MattisLind/DISKEmu-v5-1/bom/bom.csv

Designator | Quantity | Value | Footprint | Manufacturer | MPN | LCSC Part # | JLCPCB Class | Assembly | Available Order Qty | Stock Qty | Unit Price USD | Checked | Source | Notes
C1, C2, C3, C4, C5, C6, C7, C8, C9, C10, C11, C12, C13, C14, C15, C16, C31, C32, C33, C34, C35, C36, C37, C38, C39, C40, C41, C42, C43, C48, C49, C50, C51, C52, C53, C54, C55, C56, C57, C58, C59 | 41 | 100n | Capacitor_SMD:C_0603_1608Metric_Pad1.08x0.95mm_HandSolder | YAGEO | CC0603KRX7R9BB104 | C14663 | Basic | JLCPCB SMT | 16490356 | 34231944 | 0.0155 | 2026-11-07 | https://jlcpcb.com/partdetail/C14663
C17, C20 | 2 | 22u | Capacitor_Tantalum_SMD:CP_EIA-3528-21_Kemet-B_HandSolder | KYOCERA AVX | TAJB226K016RNJ | C8020 | Extended | JLCPCB SMT | 42042 | 44354 | 0.2913 | 2026-11-07 | https://jlcpcb.com/partdetail/C8020
C18, C19, C21, C22, C23, C24, C25, C26, C27, C28, C29, C30, C44, C45, C60, C61 | 16 | 4u7 | Capacitor_SMD:C_1206_3216Metric_Pad1.33x1.80mm_HandSolder | FH (Guangdong Fenghua Advanced Tech) | 1206B475K500NT | C29823 | Basic | JLCPCB SMT | 511902 | 660242 | 0.0697 | 2026-11-07 | https://jlcpcb.com/partdetail/C29823
C46, C47 | 2 | 30p C0G | Capacitor_SMD:C_0603_1608Metric_Pad1.08x0.95mm_HandSolder | FH (Guangdong Fenghua Advanced Tech) | 0603CG300J500NT | C1658 | Basic | JLCPCB SMT | 323324 | 403970 | 0.0051 | 2026-11-07 | https://jlcpcb.com/partdetail/C1658
D1 | 1 | LED Green | LED_SMD:LED_0805_2012Metric_Pad1.15x1.40mm_HandSolder | Hubei KENTO Elec | KT-0805G | C2297 | Basic | JLCPCB SMT | 1720084 | 1959976 | 0.0164 | 2026-11-07 | https://jlcpcb.com/partdetail/C2297
FB1, FB2 | 2 | 600R @100MHz | Inductor_SMD:L_0805_2012Metric_Pad1.05x1.20mm_HandSolder | Sunlord | GZ2012D601TF | C1017 | Basic | JLCPCB SMT | 381906 | 444082 | 0.02 | 2026-11-07 | https://jlcpcb.com/partdetail/C1017
J2 | 1 | TYPE-C-31-M-12 | Connector_USB:USB_C_Receptacle_HRO_TYPE-C-31-M-12 | Korean Hroparts Elec | TYPE-C-31-M-12 | C165948 | Extended | JLCPCB SMT | 307783 | 320595 | 0.1868 | 2026-11-07 | https://jlcpcb.com/partdetail/C165948
J3 | 1 | CPLD JTAG | Connector_IDC:IDC-Header_2x05_P2.54mm_Horizontal | BOOMELE(Boom Precision Elec) | 2.54-2*5PBent Header | C9140 | Extended | Hand-fit | 40414 | 41601 | 0.1237 | 2026-11-07 | https://jlcpcb.com/partdetail/C9140 | Through-hole connector/header; hand-fit or quote separate THT assembly. Check body clearance in PCB update.
J4 | 1 | AVR UPDI | Connector_IDC:IDC-Header_2x03_P2.54mm_Horizontal | BOOMELE(Boom Precision Elec) | 2.54-2*3PBent Header | C34945 | Extended | Hand-fit | 1621 | 1917 | 0.126 | 2026-11-07 | https://jlcpcb.com/partdetail/C34945 | Through-hole connector/header; hand-fit or quote separate THT assembly. Check body clearance in PCB update.
J5 | 1 | SD-CARD 11P | HP21xx_Connectors:SD_SHOUHAN_SD-CARD-11P | SHOU HAN | SD-CARD 11P | C7529393 | Extended | JLCPCB SMT | 9817 | 9934 | 0.0647 | 2026-11-07 | https://jlcpcb.com/partdetail/C7529393
J6 | 1 | DEBUG1 | Connector_PinSocket_2.54mm:PinSocket_1x04_P2.54mm_Horizontal | BOOMELE(Boom Precision Elec) | 2.54-1*4PBent round female | C88278 | Extended | Hand-fit | 328 | 329 | 0.2269 | 2026-11-07 | https://jlcpcb.com/partdetail/C88278 | Through-hole connector/header; hand-fit or quote separate THT assembly. Check body clearance in PCB update.
J7 | 1 | POWER | Connector_PinHeader_2.54mm:PinHeader_1x02_P2.54mm_Horizontal | XKB Connection | X6511WR-02H-C60D30R1 | C2883840 | Extended | Hand-fit | 2515 | 2519 | 0.0776 | 2026-11-07 | https://jlcpcb.com/partdetail/C2883840 | Through-hole connector/header; hand-fit or quote separate THT assembly. Check body clearance in PCB update.
JP1 | 1 | CONSOLE / UPDI | Connector_PinHeader_2.54mm:PinHeader_2x03_P2.54mm_Vertical | BOOMELE(Boom Precision Elec) | 2.54-2*3PPin | C65114 | Extended | Hand-fit | 60626 | 63214 | 0.0454 | 2026-11-07 | https://jlcpcb.com/partdetail/C65114 | Through-hole connector/header; hand-fit or quote separate THT assembly. Check body clearance in PCB update.
JP1 shunts (2), JP2 shunts (3) | 5 | 2.54mm removable shunt | Accessory | BOOMELE(Boom Precision Elec) | 2.54Short Circuit Cap Opening | C5305 | Extended | Accessory | 886904 | 888990 | 0.0098 | 2026-11-07 | https://jlcpcb.com/partdetail/C5305 | Fit two column-wise shunts on JP1 and three row-wise shunts on JP2.
JP2 | 1 | ONBOARD JTAG ENABLE | Connector_PinHeader_2.54mm:PinHeader_2x03_P2.54mm_Vertical | BOOMELE(Boom Precision Elec) | 2.54-2*3PPin | C65114 | Extended | Hand-fit | 60626 | 63214 | 0.0454 | 2026-11-07 | https://jlcpcb.com/partdetail/C65114 | Through-hole connector/header; hand-fit or quote separate THT assembly. Check body clearance in PCB update.
R1, R2 | 2 | 680 | Resistor_SMD:R_0603_1608Metric_Pad0.98x0.95mm_HandSolder | UNI-ROYAL(Uniroyal Elec) | 0603WAF6800T5E | C23228 | Basic | JLCPCB SMT | 1474165 | 1677487 | 0.0021 | 2026-11-07 | https://jlcpcb.com/partdetail/C23228
R3, R4, R5, R16 | 4 | 330 | Resistor_SMD:R_0603_1608Metric_Pad0.98x0.95mm_HandSolder | UNI-ROYAL(Uniroyal Elec) | 0603WAF3300T5E | C23138 | Basic | JLCPCB SMT | 2165760 | 2774987 | 0.002 | 2026-11-07 | https://jlcpcb.com/partdetail/C23138
R6, R7 | 2 | 5k1 | Resistor_SMD:R_0603_1608Metric_Pad0.98x0.95mm_HandSolder | UNI-ROYAL(Uniroyal Elec) | 0603WAF5101T5E | C23186 | Basic | JLCPCB SMT | 18976060 | 20342266 | 0.0015 | 2026-11-07 | https://jlcpcb.com/partdetail/C23186
R8, R9, R10, R11, R12, R13, R14, R15, R18, R20, R21 | 11 | 12k | Resistor_SMD:R_0603_1608Metric_Pad0.98x0.95mm_HandSolder | UNI-ROYAL(Uniroyal Elec) | 0603WAF1202T5E | C22790 | Basic | JLCPCB SMT | 967561 | 1164764 | 0.0031 | 2026-11-07 | https://jlcpcb.com/partdetail/C22790
R17, R19 | 2 | 2k2 | Resistor_SMD:R_0603_1608Metric_Pad0.98x0.95mm_HandSolder | UNI-ROYAL(Uniroyal Elec) | 0603WAF2201T5E | C4190 | Basic | JLCPCB SMT | 4386233 | 5100099 | 0.0018 | 2026-11-07 | https://jlcpcb.com/partdetail/C4190
U1, U2, U3, U4, U5 | 5 | 74HC4049 | Package_SO:SOIC-16_3.9x9.9mm_P1.27mm | Texas Instruments | CD74HC4049M96 | C2871324 | Extended | JLCPCB SMT | 995 | 1007 | 0.3599 | 2026-11-07 | https://jlcpcb.com/partdetail/C2871324
U6, U7, U8, U9, U10, U11, U12, U13, U20 | 9 | 74F38 | Package_SO:SOIC-14_3.9x8.7mm_P1.27mm | Texas Instruments | SN74F38DR | C2878705 | Extended | JLCPCB SMT | 308 | 311 | 0.4727 | 2026-11-07 | https://jlcpcb.com/partdetail/C2878705
U14 | 1 | LM1117MP-3.3 | Package_TO_SOT_SMD:SOT-223-3_TabPin2 | Texas Instruments | LM1117MPX-3.3/NOPB | C9662 | Extended | JLCPCB SMT | 35333 | 35787 | 0.2555 | 2026-11-07 | https://jlcpcb.com/partdetail/C9662
U15 | 1 | ATF1508AS-10AU100 | Package_QFP:TQFP-100_14x14mm_P0.5mm | Microchip Tech | ATF1508AS-10AU100 | C31179 | Extended | JLCPCB SMT | 7 | 7 | 22.8409 | 2026-11-07 | https://jlcpcb.com/partdetail/C31179 | Only 7 available at check; reserve/sourcing check needed for a production order.
U16 | 1 | ATF1504AS-10AU44 | Package_QFP:TQFP-44_10x10mm_P0.8mm | Microchip Tech | ATF1504AS-10AU44 | C219301 | Extended | JLCPCB SMT | 1 | 3 | 8.5551 | 2026-11-07 | https://jlcpcb.com/partdetail/C219301 | Only 1 available at check; ATF1504AS standard-power variant selected, not ASL.
U17 | 1 | AVR128DB48-I/PT | Package_QFP:TQFP-48_7x7mm_P0.5mm | Microchip Tech | AVR128DB48-I/PT | C1019766 | Extended | JLCPCB SMT | 14 | 20 | 4.9833 | 2026-11-07 | https://jlcpcb.com/partdetail/C1019766 | Only 14 available at check.
U18 | 1 | FT2232HL | Package_QFP:LQFP-64_10x10mm_P0.5mm | FTDI | FT2232HL-REEL | C27882 | Extended | JLCPCB SMT | 4603 | 4816 | 10.5864 | 2026-11-07 | https://jlcpcb.com/partdetail/C27882
U19, U22 | 2 | 74LVC1G07 | Package_TO_SOT_SMD:SOT-23-5 | Texas Instruments | SN74LVC1G07DBVR | C7829 | Extended | JLCPCB SMT | 44720 | 45029 | 0.0931 | 2026-11-07 | https://jlcpcb.com/partdetail/C7829
U21 | 1 | 93LC46B-I/SN (x16) | Package_SO:SOIC-8_3.9x4.9mm_P1.27mm | Microchip Tech | 93LC46BT-I/SN | C16253 | Extended | JLCPCB SMT | 5077 | 5128 | 0.3473 | 2026-11-07 | https://jlcpcb.com/partdetail/C16253
Y1 | 1 | 12MHz 20pF | Crystal:Crystal_SMD_3225-4Pin_3.2x2.5mm | YXC Crystal Oscillators | X322512MSB4SI | C9002 | Basic | JLCPCB SMT | 208227 | 247078 | 0.0954 | 2026-11-07 | https://jlcpcb.com/partdetail/C9002
