MattisLind/DISKEmu-v5-1/bom/pcb-features.csv

Designator | Value | Footprint | Notes
J1 | QBUSDUAL | cbscpe:Q-Bus_Dual_Edge | Part of PCB fabrication; no purchased component or LCSC number
H1 | MountingHole_Pad | MountingHole:MountingHole_3.2mm_M3_DIN965_Pad | Part of PCB fabrication; no purchased component or LCSC number
H2 | MountingHole_Pad | MountingHole:MountingHole_3.2mm_M3_DIN965_Pad | Part of PCB fabrication; no purchased component or LCSC number
