MattisLind/DISKEmu-v5-1/docs/schematic-usb-programming.pdf

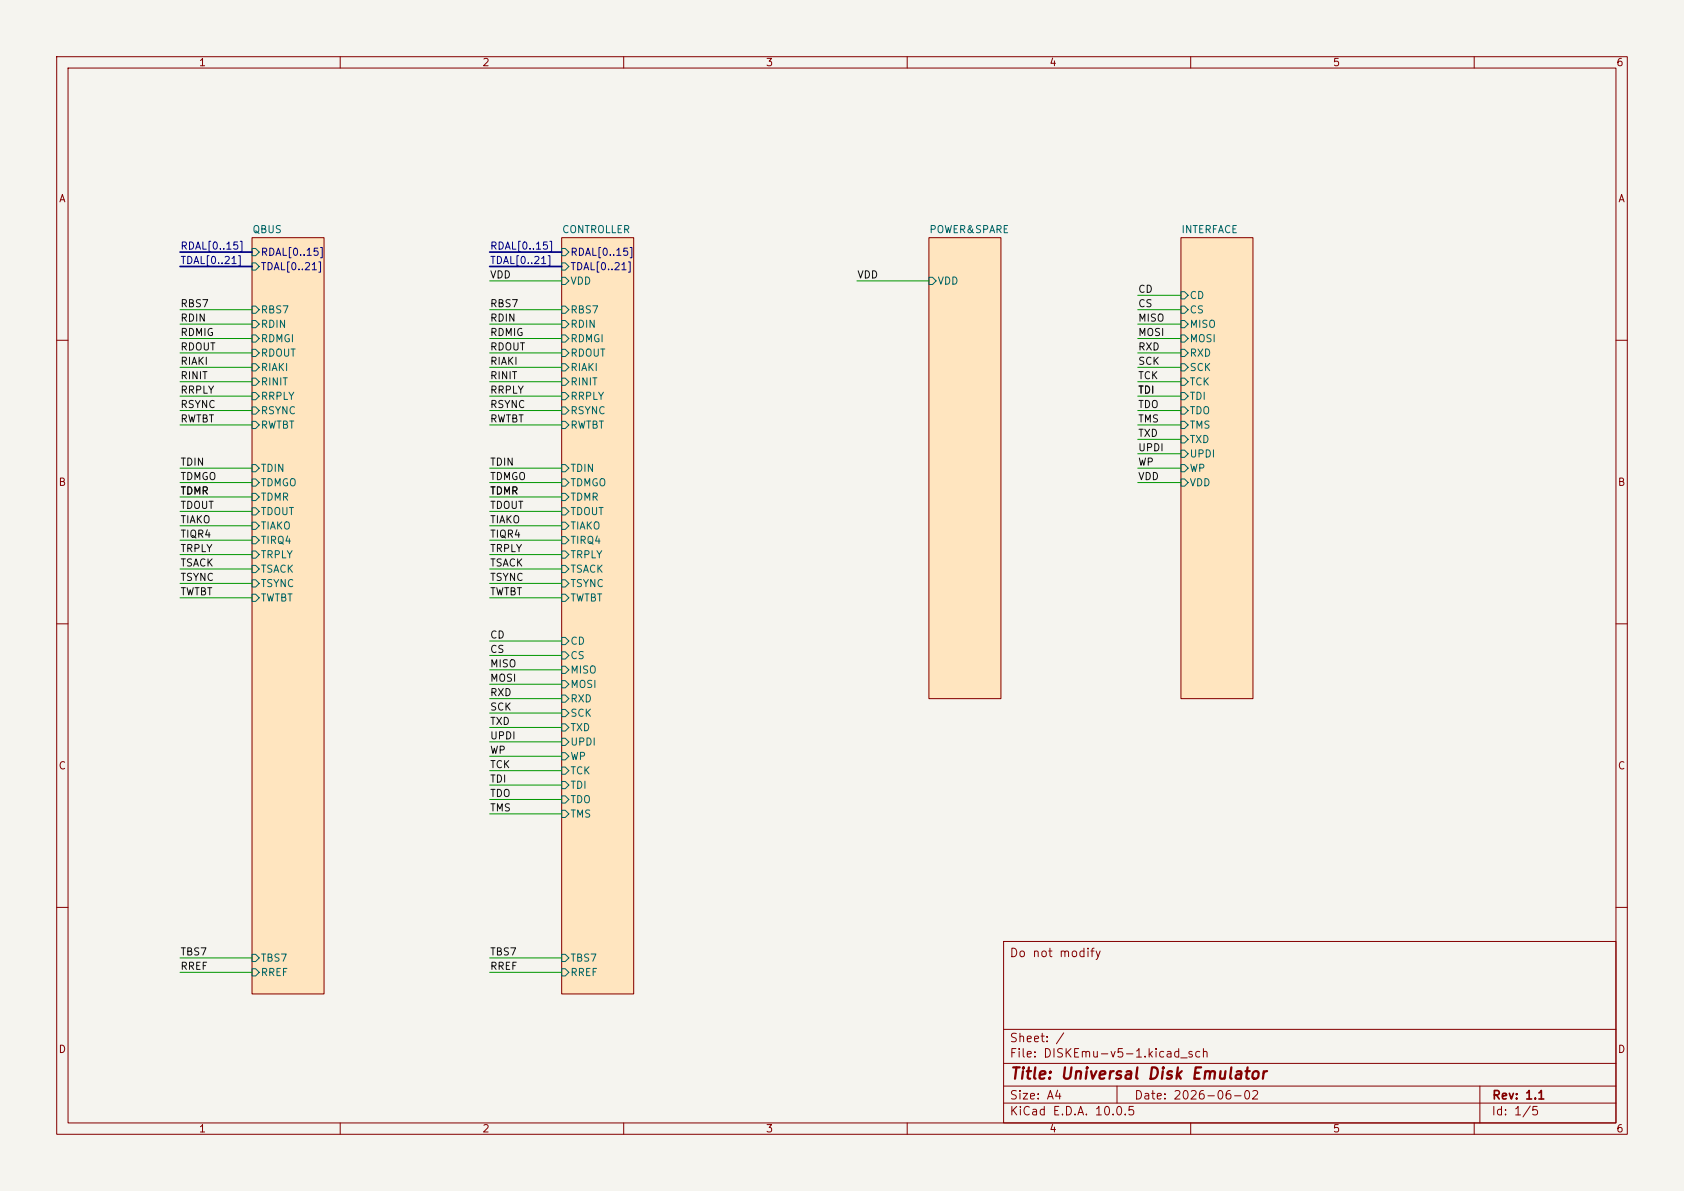
[picture p1: page 1]

INTERFACE RDOUT CD
RDAL[0..15]
TDAL[0..21] VDD
TWTBT CSRBS7 RDMIG
RDIN
RDMGI RDOUT RIAKI RINIT RRPLY RWTBT
TRPLY RINIT

RBS7
RIAKI RDMIG

Sheet: /
File: DISKEmu-v5-1.kicad_sch
Title: Universal Disk Emulator

Size: A4 | Rev: 1.1
KiCad E.D.A. 10.0.5 | Id: 1/5

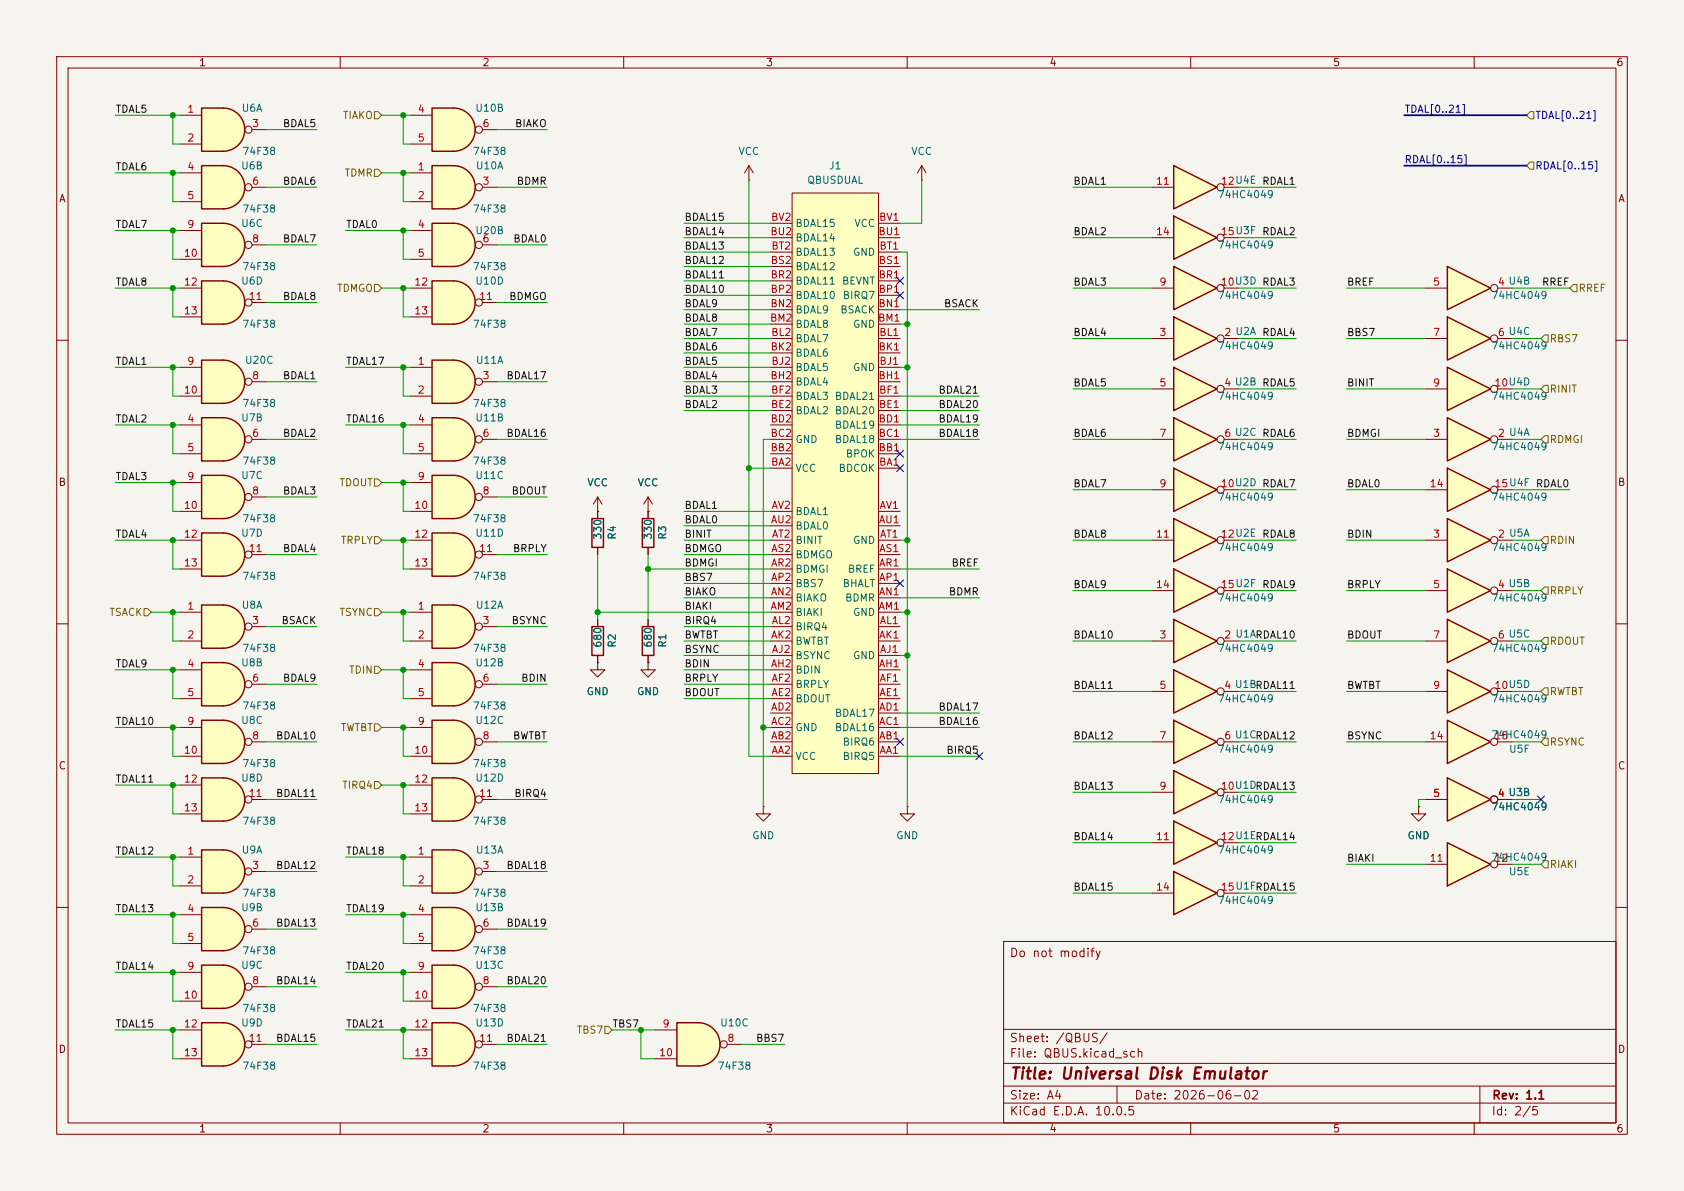
[picture p2: page 2]

RREF RBS7 RINIT RDMGI TIAKO

Do not modify GND

Sheet: /QBUS/
File: QBUS.kicad_sch
Title: Universal Disk Emulator

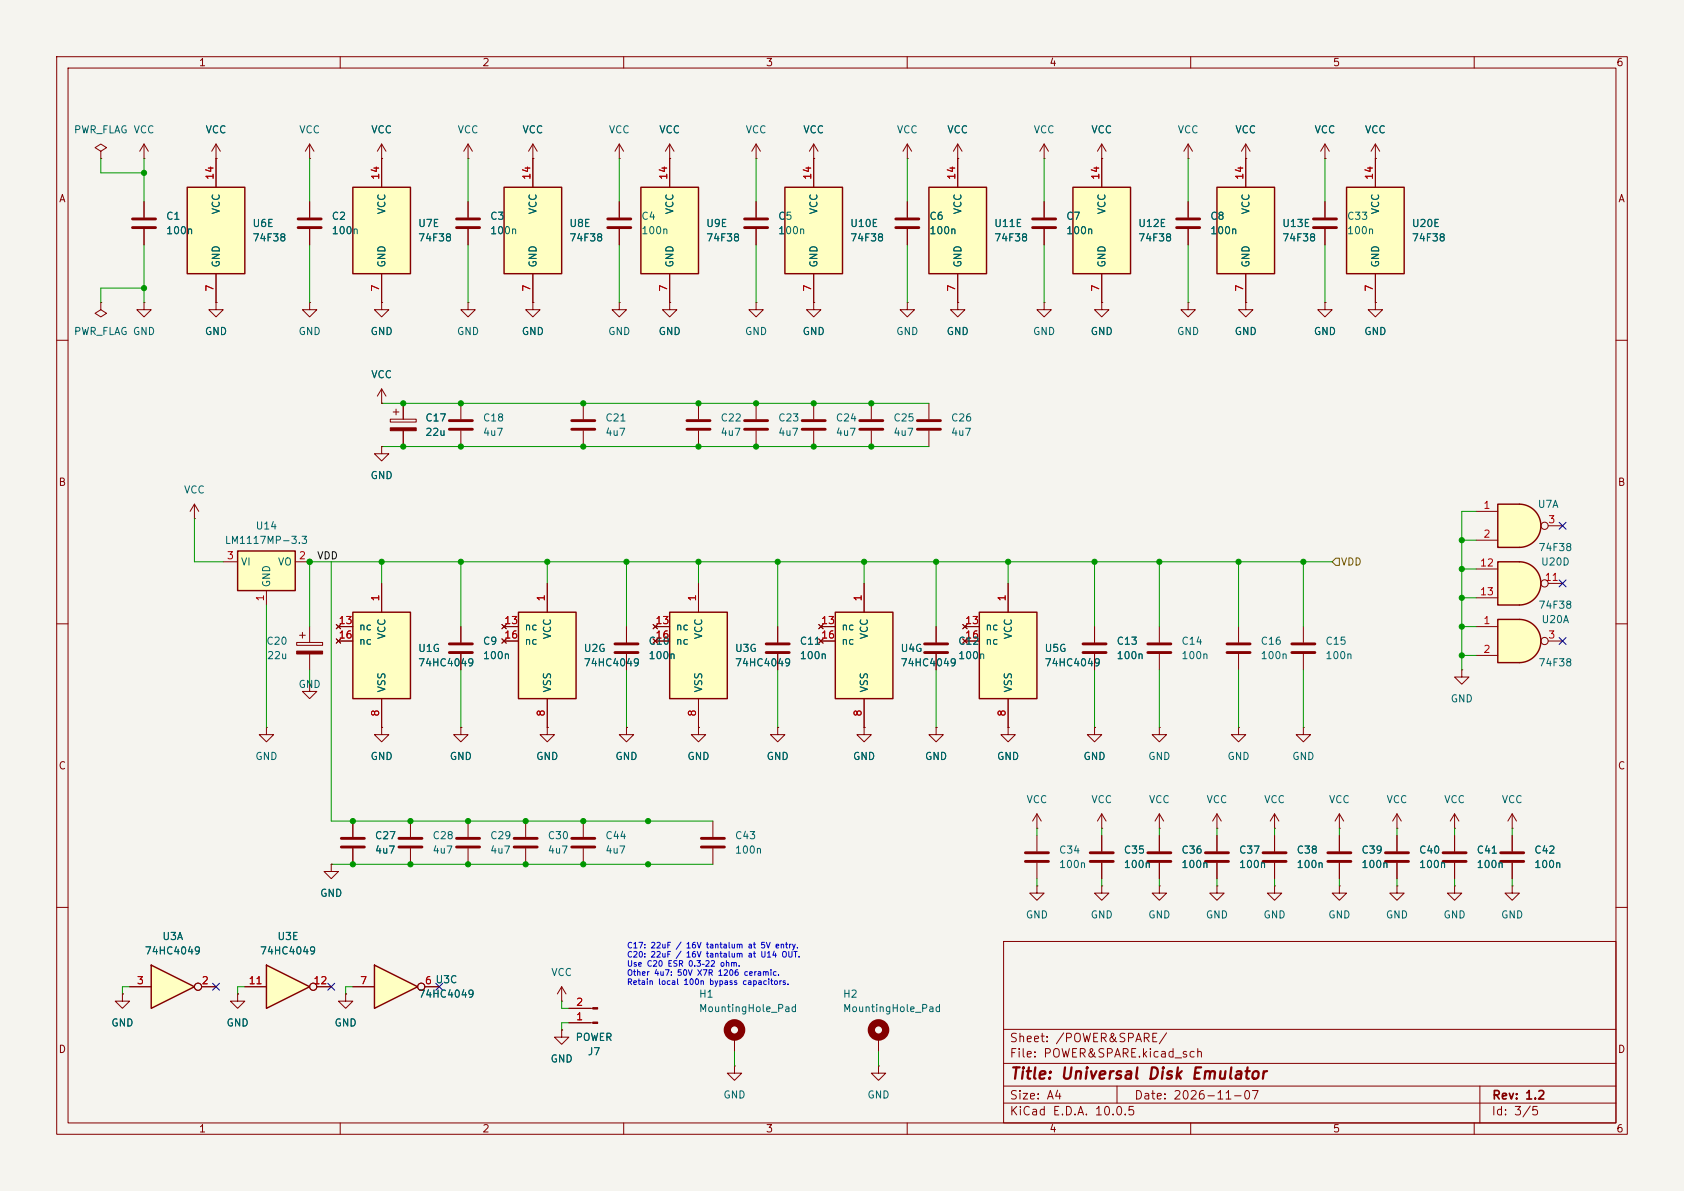
[picture p3: page 3]

Sheet: /POWER&SPARE/
File: POWER&SPARE.kicad_sch
Title: Universal Disk Emulator

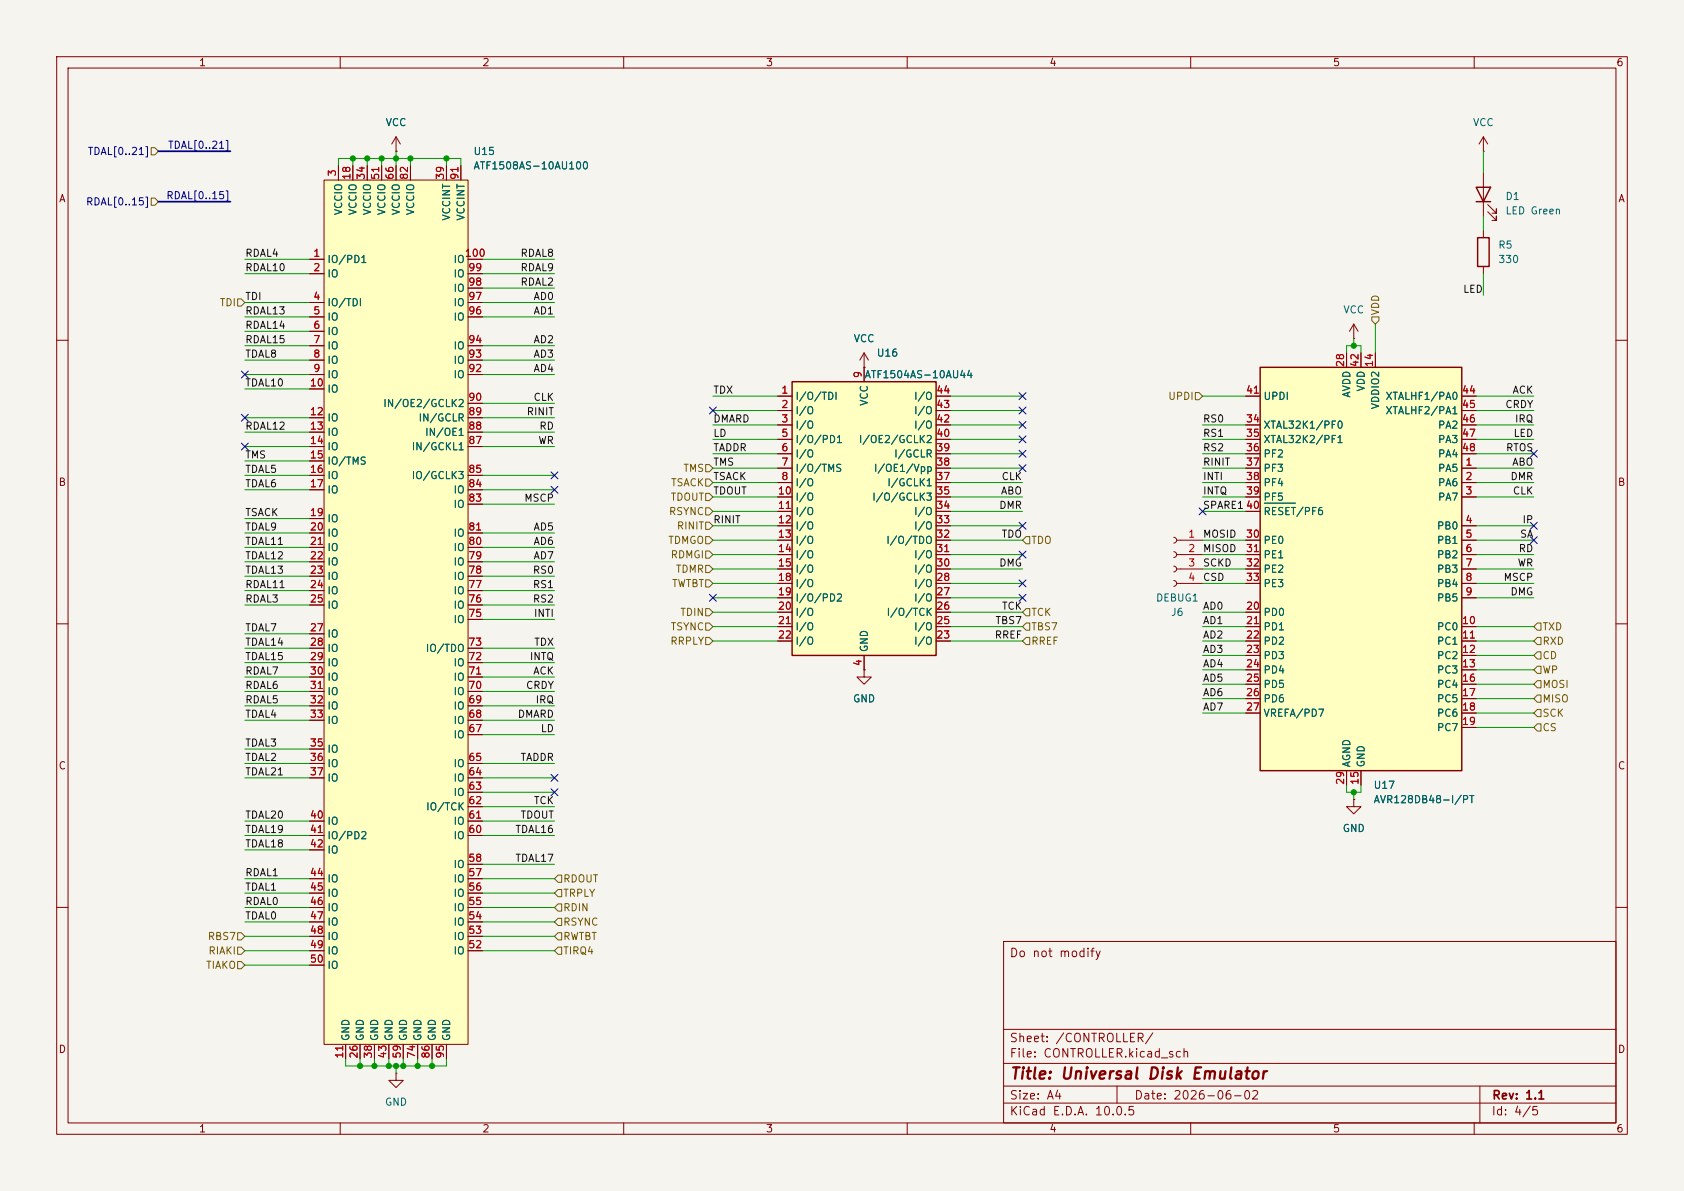
[picture p4: page 4]

ATF1508AS-10AU100

IN/GCKL1 87 IN/OE1 88 IN/GCLR 89 IN/OE2/GCLK2 90 VCCINT 91

IO 60 IO 61 IO/TCK 62 IO 63 IO 64 IO 65 VCCIO 66

IO 75 IO 76 IO 77 IO 78 IO 79 IO 80 IO 81 VCCIO 82

IO 92 IO 93 IO 94 GND 95

AD2 RDAL2 RDAL9 RDAL8

TDAL10
IO 83 IO 84 IO/GCLK3 85 GND 86

RINIT CLK

IO 67 IO 68 IO 69 IO 70 IO 71 IO 72 IO/TDO 73 GND 74

IO 52 IO 53 IO 54 IO 55 IO 56 IO 57 IO 58 GND 59

Sheet: /CONTROLLER/
File: CONTROLLER.kicad_sch
Title: Universal Disk Emulator

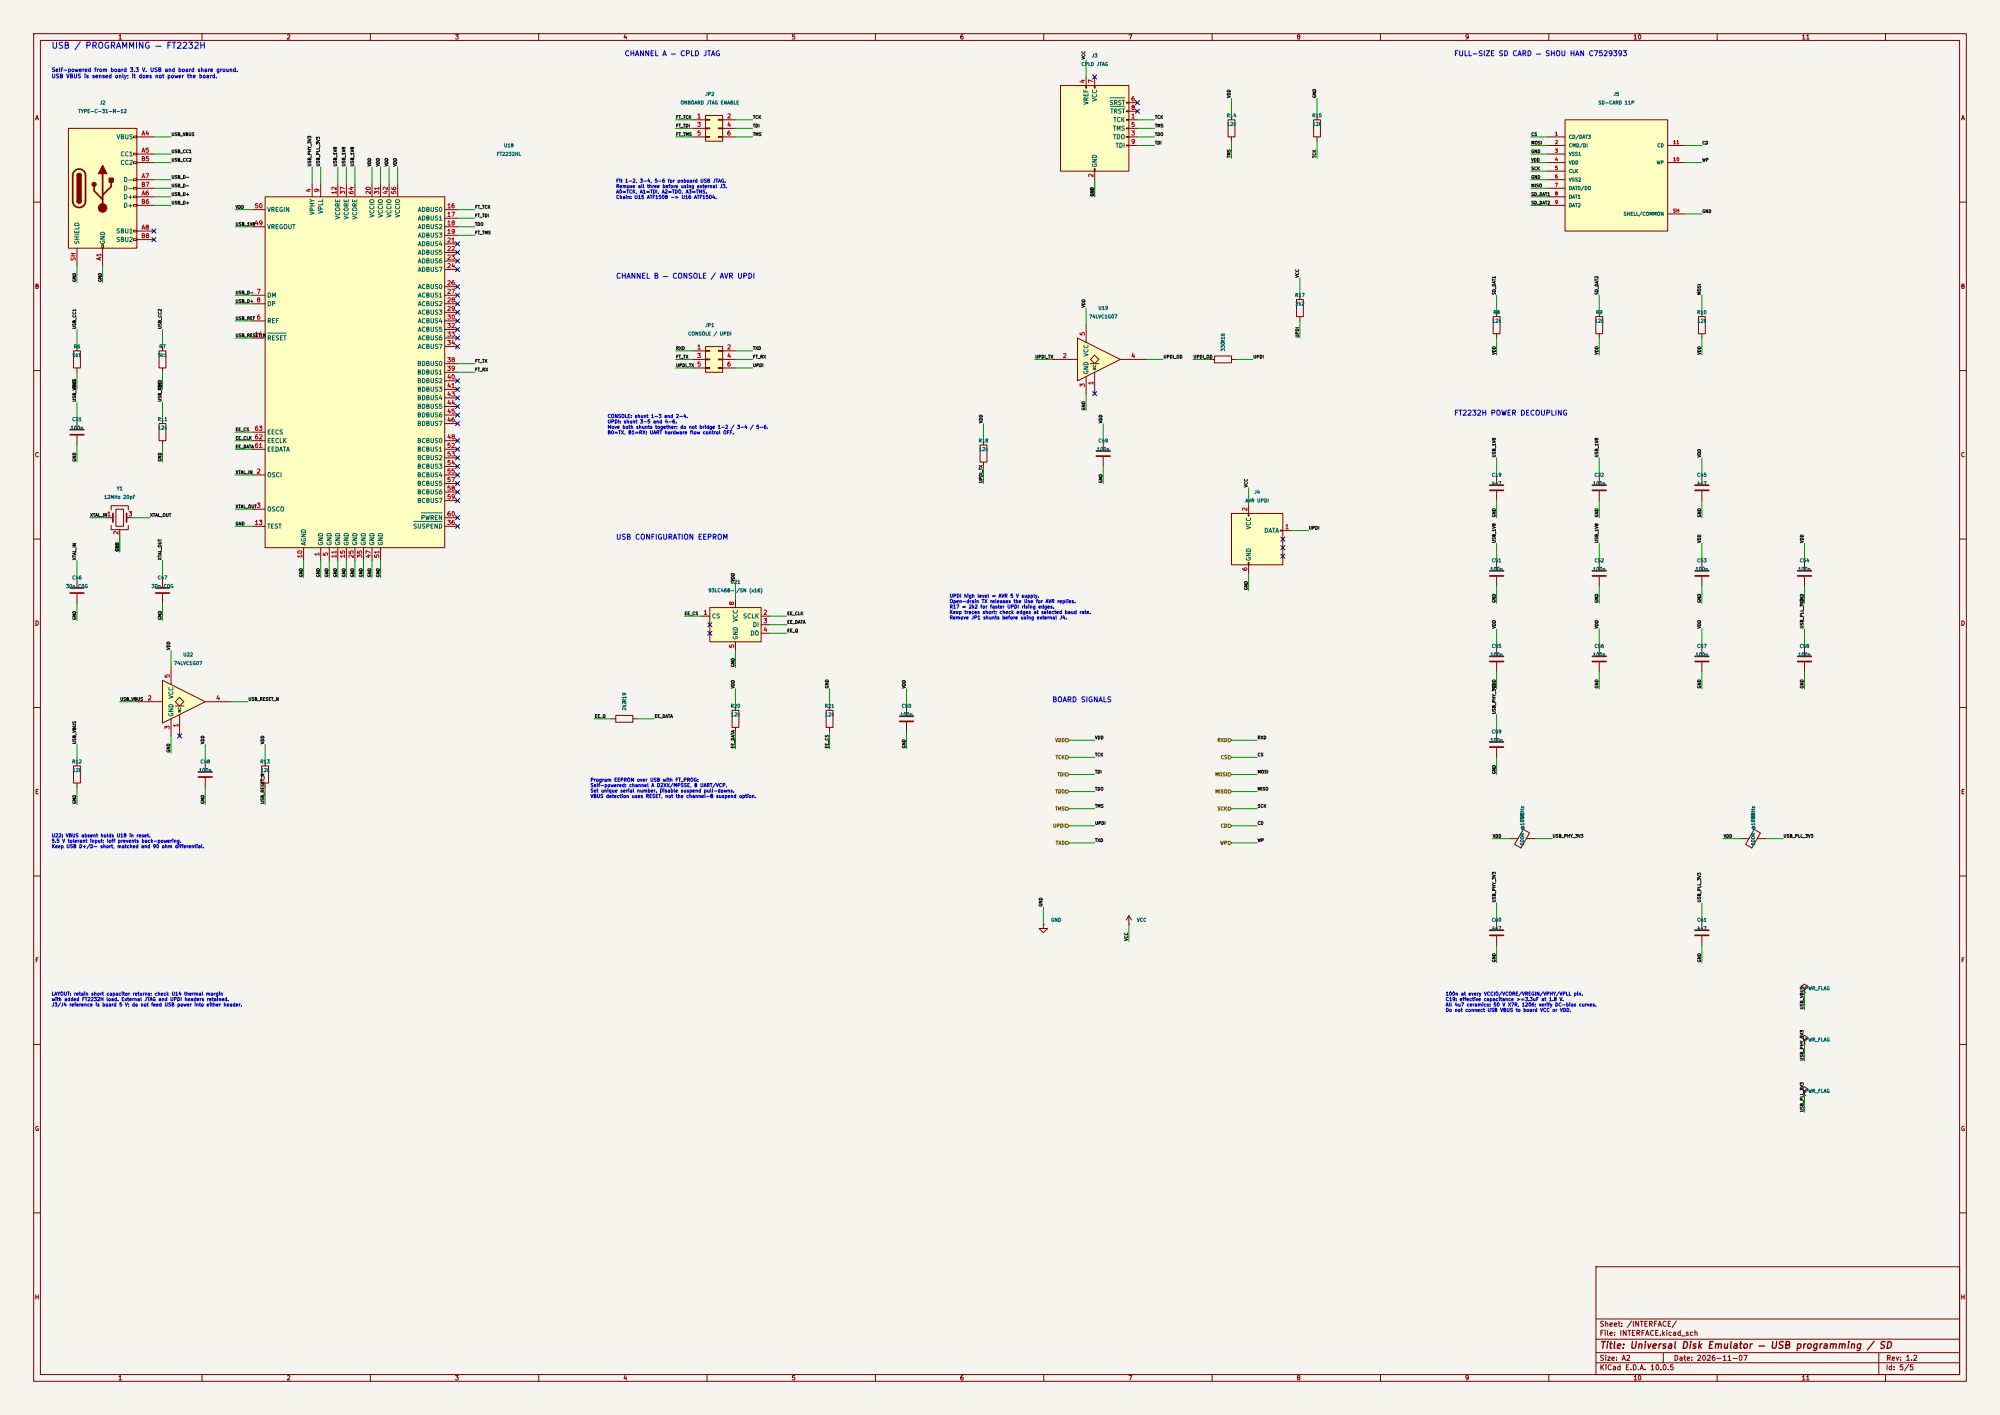
[picture p5: page 5]

FULL-SIZE SD CARD — SHOU HAN C7529393
J3 CPLD JTAG

Self-powered from board 3.3 V. USB and board share ground. USB VBUS is sensed only; it does not power the board.

Fit 1-2, 3-4, 5-6 for onboard USB JTAG. Remove all three before using external J3. A0=TCK, A1=TDI, A2=TDO, A3=TMS. Chain: U15 ATF1508 -> U16 ATF1504. CHANNEL B — CONSOLE / AVR UPDI

5 REF 6 DM 7 DP 8 VPLL 9 AGND 10 GND 11 VCORE 12

1 OSCI 2 OSCO 3 VPHY 4 GND

CONSOLE: shunt 1-3 and 2-4. UPDI: shunt 3-5 and 4-6. Move both shunts together; do not bridge 1-2 / 3-4 / 5-6. B0=TX, B1=RX; UART hardware flow control OFF.

UPDI high level = AVR 5 V supply. Open-drain TX releases the line for AVR replies. R17 = 2k2 for faster UPDI rising edges. Keep traces short; check edges at selected baud rate. Remove JP1 shunts before using external J4. BOARD SIGNALS

SCK MISO MOSI CS UPDI TMS

Program EEPROM over USB with FT_PROG: Self-powered; channel A D2XX/MPSSE, B UART/VCP. Set unique serial number. Disable suspend pull-downs. VBUS detection uses RESET, not the channel-B suspend option.

U22: VBUS absent holds U18 in reset. 5.5 V tolerant input; Ioff prevents back-powering. Keep USB D+/D- short, matched and 90 ohm differential.

LAYOUT: retain short capacitor returns; check U14 thermal margin with added FT2232H load. External JTAG and UPDI headers retained. J3/J4 reference is board 5 V; do not feed USB power into either header.

100n at every VCCIO/VCORE/VREGIN/VPHY/VPLL pin. C19: effective capacitance >=3.3uF at 1.8 V. All 4u7 ceramics: 50 V X7R, 1206; verify DC-bias curves. Do not connect USB VBUS to board VCC or VDD.

Sheet: /INTERFACE/
File: INTERFACE.kicad_sch
Title: Universal Disk Emulator — USB programming / SD
