MattisLind/DISKEmu-v5-1/DISKEmu-QBUS/DISKEmu-v5-1.kicad_pcb

## KiCad design DISKEmu-QBUS/DISKEmu-v5-1.kicad_pcb (2026-11-07)

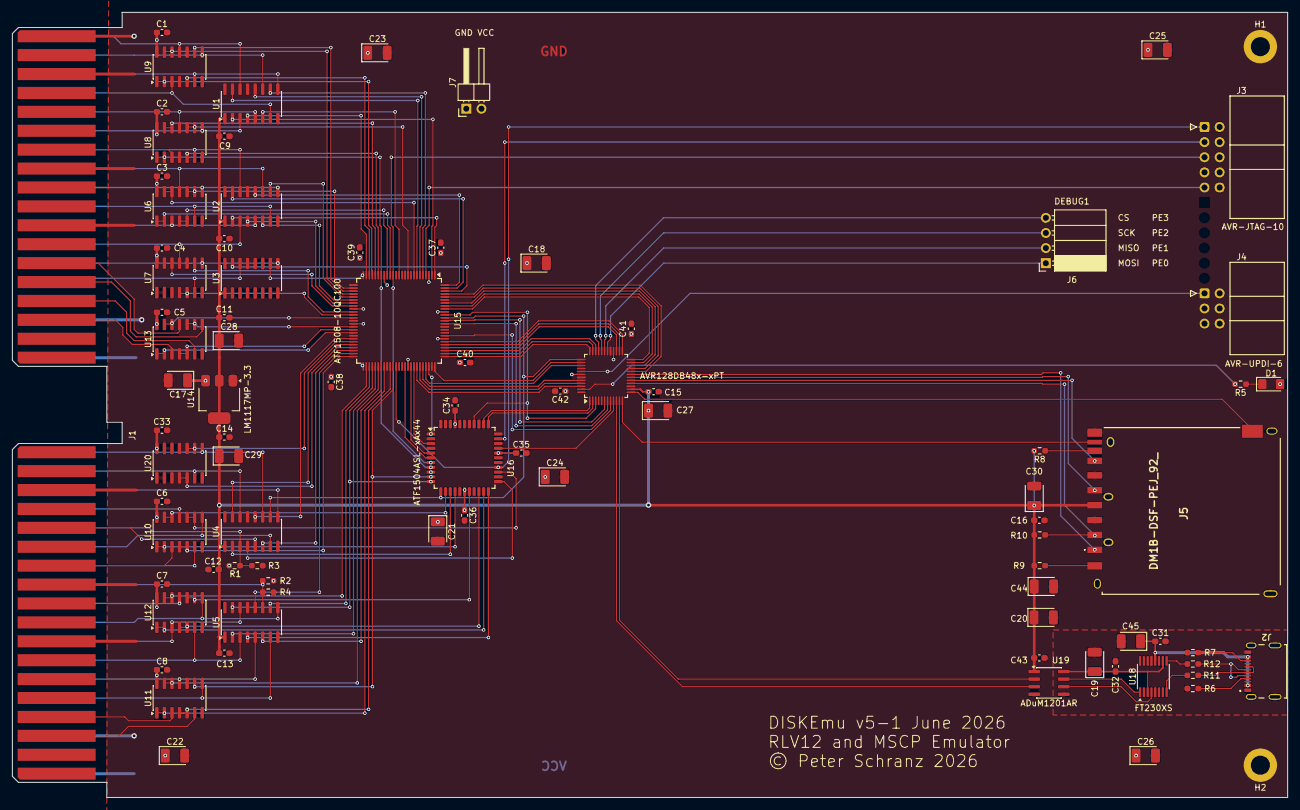
[picture p6: board DISKEmu-v5-1.kicad_pcb from above]

Board: 2 copper layers, 214.1 x 131.8 mm, 87 parts (0 on the bottom side), 158 nets.

Parts:
C1, C2, C3, C4, C5, C6, C7, C8, C9, C10, C11, C12, C13, C14, C15, C16, C33, C34, C35, C36, C37, C38, C39, C40, C41, C42, C43: 100n; C_0603_1608Metric_Pad1.08x0.95mm_HandSolder
C17, C18, C19, C20, C21, C22, C23, C24, C25, C26, C27, C28, C29, C30, C44, C45: 4u7; CP_EIA-3528-12_Kemet-T_HandSolder
C31, C32: 220n; C_0603_1608Metric_Pad1.08x0.95mm_HandSolder
D1: LED; LED_1206_3216Metric_Pad1.42x1.75mm_HandSolder
H1, H2: MountingHole_Pad; MountingHole_3.2mm_M3_DIN965_Pad
J1: QBUSDUAL; Q-Bus_Dual_Edge
J2: USB4215-03-A_REVA; GCT_USB4215-03-A-REVB
J3: AVR-JTAG-10; IDC-Header_2x05_P2.54mm_Horizontal
J4: AVR-UPDI-6; IDC-Header_2x03_P2.54mm_Horizontal
J5: DM1B-DSF-PEJ_92_; DM1B-DSF-PEJ92
J6: DEBUG1; PinSocket_1x04_P2.54mm_Horizontal
J7: POWER; PinHeader_1x02_P2.54mm_Horizontal
R1, R2: 680; R_0603_1608Metric_Pad0.98x0.95mm_HandSolder
R3, R4: 330; R_0603_1608Metric_Pad0.98x0.95mm_HandSolder
R5: 120; R_0603_1608Metric_Pad0.98x0.95mm_HandSolder
R6, R7: 5k1; R_0603_1608Metric_Pad0.98x0.95mm_HandSolder
R8, R9, R10: 2k2; R_0603_1608Metric_Pad0.98x0.95mm_HandSolder
R11, R12: 27R; R_0603_1608Metric_Pad0.98x0.95mm_HandSolder
U1, U2, U3, U4, U5: 74HC4049; SOIC-16_3.9x9.9mm_P1.27mm
U6, U7, U8, U9, U10, U11, U12, U13, U20: 74F38; SOIC-14_3.9x8.7mm_P1.27mm
U14: LM1117MP-3.3; SOT-223-3_TabPin2
U15: ATF1508-10QC100; TQFP-100_14x14mm_P0.5mm
U16: ATF1504ASL-xAx44; TQFP-44_10x10mm_P0.8mm
U17: AVR128DB48x-xPT; TQFP-48_7x7mm_P0.5mm
U18: FT230XS; SSOP-16_3.9x4.9mm_P0.635mm
U19: ADuM1201AR; SOIC-8_3.9x4.9mm_P1.27mm

Connections:
/CD: J5.10 (CARD_DETECT), U17.12 (PC2)
/CONTROLLER/ABO: U16.35 (I/O/GCLK3), U17.1 (PA5)
/CONTROLLER/ACK: U15.71 (IO), U17.44 (XTALHF1/PA0)
/CONTROLLER/AD0: U15.97 (IO), U17.20 (PD0)
/CONTROLLER/AD1: U15.96 (IO), U17.21 (PD1)
/CONTROLLER/AD2: U15.94 (IO), U17.22 (PD2)
/CONTROLLER/AD3: U15.93 (IO), U17.23 (PD3)
/CONTROLLER/AD4: U15.92 (IO), U17.24 (PD4)
/CONTROLLER/AD5: U15.81 (IO), U17.25 (PD5)
/CONTROLLER/AD6: U15.80 (IO), U17.26 (PD6)
/CONTROLLER/AD7: U15.79 (IO), U17.27 (VREFA/PD7)
/CONTROLLER/CLK: U15.90 (IN/OE2/GCLK2), U16.37 (I/GCLK1), U17.3 (PA7)
/CONTROLLER/CRDY: U15.70 (IO), U17.45 (XTALHF2/PA1)
/CONTROLLER/CSD: J6.4, U17.33 (PE3)
/CONTROLLER/DMARD: U15.68 (IO), U16.3 (I/O)
/CONTROLLER/DMG: U16.30 (I/O), U17.9 (PB5)
/CONTROLLER/DMR: U16.34 (I/O), U17.2 (PA6)
/CONTROLLER/INTI: U15.75 (IO), U17.38 (PF4)
/CONTROLLER/INTQ: U15.72 (IO), U17.39 (PF5)
/CONTROLLER/IRQ: U15.69 (IO), U17.46 (PA2)
/CONTROLLER/LD: U15.67 (IO), U16.5 (I/O/PD1)
/CONTROLLER/LED: R5.2, U17.47 (PA3)
/CONTROLLER/MISOD: J6.2, U17.31 (PE1)
/CONTROLLER/MOSID: J6.1, U17.30 (PE0)
/CONTROLLER/MSCP: U15.83 (IO), U17.8 (PB4)
/CONTROLLER/RD: U15.88 (IN/OE1), U17.6 (PB2)
/CONTROLLER/RS0: U15.78 (IO), U17.34 (XTAL32K1/PF0)
/CONTROLLER/RS1: U15.77 (IO), U17.35 (XTAL32K2/PF1)
/CONTROLLER/RS2: U15.76 (IO), U17.36 (PF2)
/CONTROLLER/SCKD: J6.3, U17.32 (PE2)
/CONTROLLER/TADDR: U15.65 (IO), U16.6 (I/O)
/CONTROLLER/TDX: U15.73 (IO/TDO), U16.1 (I/O/TDI)
/CONTROLLER/WR: U15.87 (IN/GCKL1), U17.7 (PB3)
/CS: J5.1 (CD/DAT3), U17.19 (PC7)
/MISO: J5.7 (DAT0/DO), U17.17 (PC5)
/MOSI: J5.2 (CMD/DI), R10.1, U17.16 (PC4)
/QBUS/BBS7: J1.AP2 (BBS7), U4.7, U10.8
/QBUS/BDAL0: J1.AU2 (BDAL0), U4.14, U20.6
/QBUS/BDAL1: J1.AV2 (BDAL1), U4.11, U20.8
/QBUS/BDAL2: J1.BE2 (BDAL2), U3.14, U7.6
/QBUS/BDAL3: J1.BF2 (BDAL3), U3.9, U7.8
/QBUS/BDAL4: J1.BH2 (BDAL4), U2.3, U7.11
/QBUS/BDAL5: J1.BJ2 (BDAL5), U2.5, U6.3
/QBUS/BDAL6: J1.BK2 (BDAL6), U2.7, U6.6
/QBUS/BDAL7: J1.BL2 (BDAL7), U2.9, U6.8
/QBUS/BDAL8: J1.BM2 (BDAL8), U2.11, U6.11
/QBUS/BDAL9: J1.BN2 (BDAL9), U2.14, U8.6
/QBUS/BDAL10: J1.BP2 (BDAL10), U1.3, U8.8
/QBUS/BDAL11: J1.BR2 (BDAL11), U1.5, U8.11
/QBUS/BDAL12: J1.BS2 (BDAL12), U1.7, U9.3
/QBUS/BDAL13: J1.BT2 (BDAL13), U1.9, U9.6
/QBUS/BDAL14: J1.BU2 (BDAL14), U1.11, U9.8
/QBUS/BDAL15: J1.BV2 (BDAL15), U1.14, U9.11
/QBUS/BDAL16: J1.AC1 (BDAL16), U11.6
/QBUS/BDAL17: J1.AD1 (BDAL17), U11.3
/QBUS/BDAL18: J1.BC1 (BDAL18), U13.3
/QBUS/BDAL19: J1.BD1 (BDAL19), U13.6
/QBUS/BDAL20: J1.BE1 (BDAL20), U13.8
/QBUS/BDAL21: J1.BF1 (BDAL21), U13.11
/QBUS/BDIN: J1.AH2 (BDIN), U5.3, U12.6
/QBUS/BDMGI: J1.AR2 (BDMGI), R1.1, R3.2, U4.3
/QBUS/BDMGO: J1.AS2 (BDMGO), U10.11
/QBUS/BDMR: J1.AN1 (BDMR), U10.3
/QBUS/BDOUT: J1.AE2 (BDOUT), U5.7, U11.8
/QBUS/BIAKI: J1.AM2 (BIAKI), R2.1, R4.2, U5.11
/QBUS/BIAKO: J1.AN2 (BIAKO), U10.6
/QBUS/BINIT: J1.AT2 (BINIT), U4.9
/QBUS/BIRQ4: J1.AL2 (BIRQ4), U12.11
/QBUS/BREF: J1.AR1 (BREF), U4.5
/QBUS/BRPLY: J1.AF2 (BRPLY), U5.5, U11.11
/QBUS/BSACK: J1.BN1 (BSACK), U8.3
/QBUS/BSYNC: J1.AJ2 (BSYNC), U5.14, U12.3
/QBUS/BWTBT: J1.AK2 (BWTBT), U5.9, U12.8
/RBS7: U4.6, U15.48 (IO)
/RDAL0: U4.15, U15.46 (IO)
/RDAL1: U4.12, U15.44 (IO)
/RDAL2: U3.15, U15.98 (IO)
/RDAL3: U3.10, U15.25 (IO)
/RDAL4: U2.2, U15.1 (IO/PD1)
/RDAL5: U2.4, U15.32 (IO)
/RDAL6: U2.6, U15.31 (IO)
/RDAL7: U2.10, U15.30 (IO)
/RDAL8: U2.12, U15.100 (IO)
/RDAL9: U2.15, U15.99 (IO)
/RDAL10: U1.2, U15.2 (IO)
/RDAL11: U1.4, U15.24 (IO)
/RDAL12: U1.6, U15.13 (IO)
/RDAL13: U1.10, U15.5 (IO)
/RDAL14: U1.12, U15.6 (IO)
/RDAL15: U1.15, U15.7 (IO)
/RDIN: U5.2, U15.55 (IO)
/RDMIG: U4.2, U16.14 (I/O)
/RDOUT: U5.6, U15.57 (IO)
/RIAKI: U5.12, U15.49 (IO)
/RINIT: U4.10, U15.89 (IN/GCLR), U16.12 (I/O), U17.37 (PF3)
/RREF: U4.4, U16.23 (I/O)
/RRPLY: U5.4, U16.22 (I/O)
/RSYNC: U5.15, U15.54 (IO), U16.11 (I/O)
/RWTBT: U5.10, U15.53 (IO)
/RXD: U17.11 (PC1), U19.2 (VOA)
/SCK: J5.5 (CLK), U17.18 (PC6)
/TBS7: U10.9, U10.10, U16.25 (I/O)
/TCK: J3.1 (TCK), U15.62 (IO/TCK), U16.26 (I/O/TCK)
/TDAL0: U15.47 (IO), U20.4, U20.5
/TDAL1: U15.45 (IO), U20.9, U20.10
/TDAL2: U7.4, U7.5, U15.36 (IO)
/TDAL3: U7.9, U7.10, U15.35 (IO)
/TDAL4: U7.12, U7.13, U15.33 (IO)
/TDAL5: U6.1, U6.2, U15.16 (IO)
/TDAL6: U6.4, U6.5, U15.17 (IO)
/TDAL7: U6.9, U6.10, U15.27 (IO)
/TDAL8: U6.12, U6.13, U15.8 (IO)
/TDAL9: U8.4, U8.5, U15.20 (IO)
/TDAL10: U8.9, U8.10, U15.10 (IO)
/TDAL11: U8.12, U8.13, U15.21 (IO)
/TDAL12: U9.1, U9.2, U15.22 (IO)
/TDAL13: U9.4, U9.5, U15.23 (IO)
/TDAL14: U9.9, U9.10, U15.28 (IO)
/TDAL15: U9.12, U9.13, U15.29 (IO)
/TDAL16: U11.4, U11.5, U15.60 (IO)
/TDAL17: U11.1, U11.2, U15.58 (IO)
/TDAL18: U13.1, U13.2, U15.42 (IO)
/TDAL19: U13.4, U13.5, U15.41 (IO/PD2)
/TDAL20: U13.9, U13.10, U15.40 (IO)
/TDAL21: U13.12, U13.13, U15.37 (IO)
/TDI: J3.9 (TDI), U15.4 (IO/TDI)
/TDIN: U12.4, U12.5, U16.20 (I/O)
/TDMGO: U10.12, U10.13, U16.13 (I/O)
/TDMR: U10.1, U10.2, U16.15 (I/O)
/TDO: J3.3 (TDO), U16.32 (I/O/TDO)
/TDOUT: U11.9, U11.10, U15.61 (IO), U16.10 (I/O)
/TIAKO: U10.4, U10.5, U15.50 (IO)
/TIQR4: U12.12, U12.13, U15.52 (IO)
/TMS: J3.5 (TMS), U15.15 (IO/TMS), U16.7 (I/O/TMS)
/TRPLY: U11.12, U11.13, U15.56 (IO)
/TSACK: U8.1, U8.2, U15.19 (IO), U16.8 (I/O)
/TSYNC: U12.1, U12.2, U16.21 (I/O)
/TWTBT: U12.9, U12.10, U16.18 (I/O)
/TXD: U17.10 (PC0), U19.3 (VIB)
/UPDI: J4.1 (DATA), U17.41 (UPDI)
/VDD: C9.1, C10.1, C11.1, C12.1, C13.1, C14.1, C15.1, C16.1, C20.1, C27.1, C28.1, C29.1, C30.1, C43.1, C44.1, J5.4 (VDD), R8.2, R9.2, R10.2, U1.1 (VCC), U2.1 (VCC), U3.1 (VCC), U4.1 (VCC), U5.1 (VCC), U14.2 (VO), U17.14 (VDDIO2), U19.1 (VDD1)
/WP: J5.18 (WP), U17.13 (PC3)
GND: C1.2, C2.2, C3.2, C4.2, C5.2, C6.2, C7.2, C8.2, C9.2, C10.2, C11.2, C12.2, C13.2, C14.2, C15.2, C16.2, C17.2, C18.2, C20.2, C21.2, C22.2, C23.2, C24.2, C25.2, C26.2, C27.2, C28.2, C29.2, C30.2, C33.2, C34.2, C35.2, C36.2, C37.2, C38.2, C39.2, C40.2, C41.2, C42.2, C43.2, C44.2, H1.1 (1_1), H2.1 (1_1), J1.AC2 (GND), J1.AJ1 (GND), J1.AM1 (GND), J1.AT1 (GND), J1.BC2 (GND), J1.BJ1 (GND), J1.BM1 (GND), J1.BT1 (GND), J3.2 (GND), J3.10 (GND), J4.6 (GND), J5.3 (VSS1), J5.6 (VSS2), J5.11 (COMMON_FOR_CD_AND_WP), J5.12 (MH1), J5.13 (MH2), J5.14 (MH3), J5.15 (MH4), J5.16 (MH5), J5.17 (MH6), J7.1, R1.2, R2.2, U1.8 (VSS), U2.8 (VSS), U3.3, U3.5, U3.7, U3.8 (VSS), U3.11, U4.8 (VSS), U5.8 (VSS), U6.7 (GND), U7.1, U7.2, U7.7 (GND), U8.7 (GND), U9.7 (GND), U10.7 (GND), U11.7 (GND), U12.7 (GND), U13.7 (GND), U14.1 (GND), U15.11 (GND), U15.26 (GND), U15.38 (GND), U15.43 (GND), U15.59 (GND), U15.74 (GND), U15.86 (GND), U15.95 (GND), U16.4 (GND), U16.16 (GND), U16.24 (GND), U16.36 (GND), U17.15 (GND), U17.29 (AGND), U17.43 (GND), U19.4 (GND1), U20.1, U20.2, U20.7 (GND), U20.12, U20.13
GND2: C19.2, C31.2, C32.2, C45.2, J2.A1_B12 (GND_A), J2.B1_A12 (GND_B), J2.SH1 (SHIELD), J2.SH2 (SHIELD), J2.SH3 (SHIELD), J2.SH4 (SHIELD), R6.1, R7.2, U18.5 (GND), U18.13 (GND), U19.5 (GND2)
unnamed: D1.1 (K), R5.1
unnamed: J2.A5 (CC1), R6.2
unnamed: J2.B5 (CC2), R7.1
unnamed: J2.A7 (DN1), J2.B7 (DN2), R12.2
unnamed: J2.A6 (DP1), J2.B6 (DP2), R11.1
unnamed: C31.1, C45.1, J2.A4_B9 (VBUS_A), J2.B4_A9 (VBUS_B), U18.12 (VCC)
unnamed: J5.8 (DAT1), R8.1
unnamed: J5.9 (DAT2), R9.1
unnamed: C19.1, C32.1, U18.3 (VCCIO), U18.10 (3V3OUT), U19.8 (VDD2)
unnamed: U18.4 (RXD), U19.6 (VOB)
unnamed: U18.1 (TXD), U19.7 (VIA)
unnamed: R12.1, U18.9 (USBDM)
unnamed: R11.2, U18.8 (USBDP)
VCC: C1.1, C2.1, C3.1, C4.1, C5.1, C6.1, C7.1, C8.1, C17.1, C18.1, C21.1, C22.1, C23.1, C24.1, C25.1, C26.1, C33.1, C34.1, C35.1, C36.1, C37.1, C38.1, C39.1, C40.1, C41.1, C42.1, D1.2 (A), J1.AA2 (VCC), J1.BA2 (VCC), J1.BV1 (VCC), J3.4 (VREF), J4.2 (VCC), J7.2, R3.1, R4.1, U6.14 (VCC), U7.14 (VCC), U8.14 (VCC), U9.14 (VCC), U10.14 (VCC), U11.14 (VCC), U12.14 (VCC), U13.14 (VCC), U14.3 (VI), U15.3 (VCCIO), U15.18 (VCCIO), U15.34 (VCCIO), U15.39 (VCCINT), U15.51 (VCCIO), U15.66 (VCCIO), U15.82 (VCCIO), U15.91 (VCCINT), U16.9 (VCC), U16.17 (VCC), U16.29 (VCC), U16.41 (VCC), U17.28 (AVDD), U17.42 (VDD), U20.14 (VCC)
