MattisLind/DISKEmu-v5-1/(commit log)

2026-07-28 Correct values for ATF1508 and 74HC4049 to get a correct BOM
    [DISKEmu-v5-1.kicad_pcb, POWER&SPARE.kicad_sch, QBUS.kicad_sch]
2026-07-30 Add picutres of all pages of the schematic
2026-11-07 Adding in all needed stuff for this project. Creating a BOM.
    [CONTROLLER.kicad_sch, DISKEmu-v5-1.kicad_pcb, INTERFACE.kicad_sch, POWER&SPARE.kicad_sch, QBUS.kicad_sch, bom.csv, hand-assembly.csv, jlcpcb-bom.csv]
2026-11-07 Moved around files.
    [CONTROLLER.kicad_sch, DISKEmu-v5-1.kicad_pcb, DISKEmu-v5-1.kicad_sch, INTERFACE.kicad_sch, POWER&SPARE.kicad_sch, QBUS.kicad_sch]
2026-11-07 Added tooling to assemble the AVR firmware.
