MattisLind/DISKEmu-v5-1/(notices)

Notices in the files:
DISKEmu-QBUS/DISKEmu-v5-1.kicad_pcb:
© Peter Schranz 2026
